OmarTRBN/STM32_Robotic_Arm/README.md

# STM32_Robotic_Arm
Capstone project - STM32-controlled 4DOF robotic arm designed for trajectory tracking, controller comparison and system identification experiments.
