OmarTRBN/STM32_Robotic_Arm/Images/FrontView.png

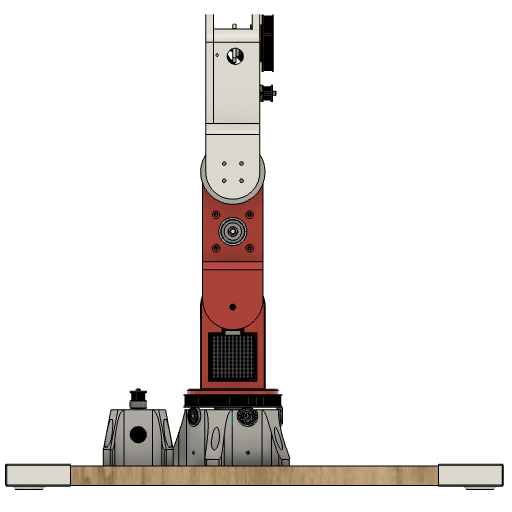
Images/FrontView.png
