OmarTRBN/STM32_Robotic_Arm/Images/HomeView.png

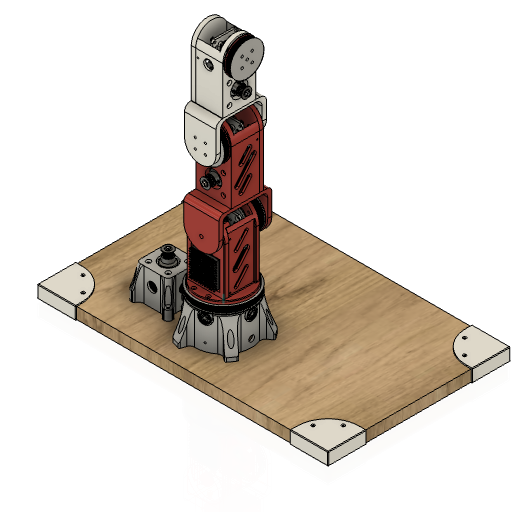
Images/HomeView.png
