OmarTRBN/STM32_Robotic_Arm/Images/link1_analysis.png

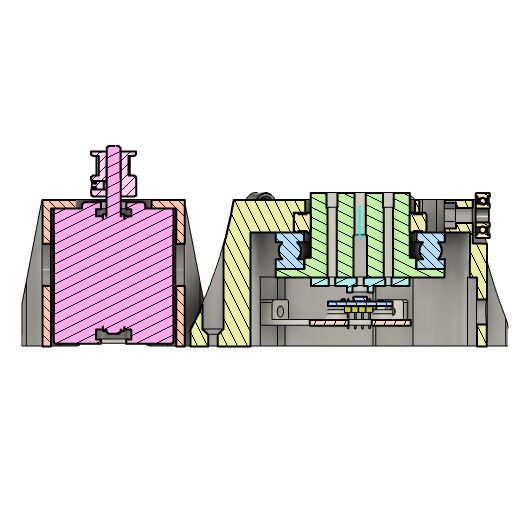
Images/link1_analysis.png
