OmarTRBN/STM32_Robotic_Arm/Images/link2_analysis.png

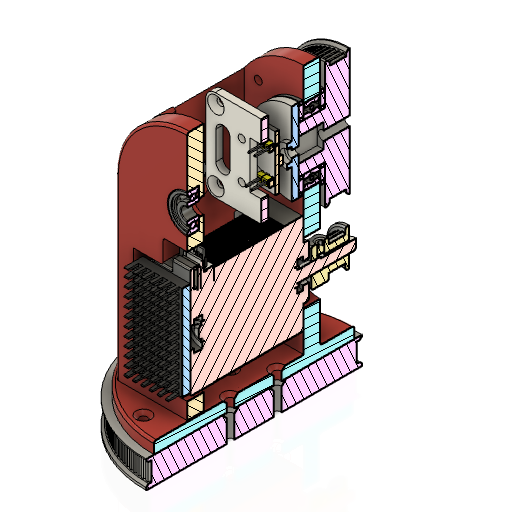
Images/link2_analysis.png
