OmarTRBN/STM32_Robotic_Arm/Images/link3_analysis.png

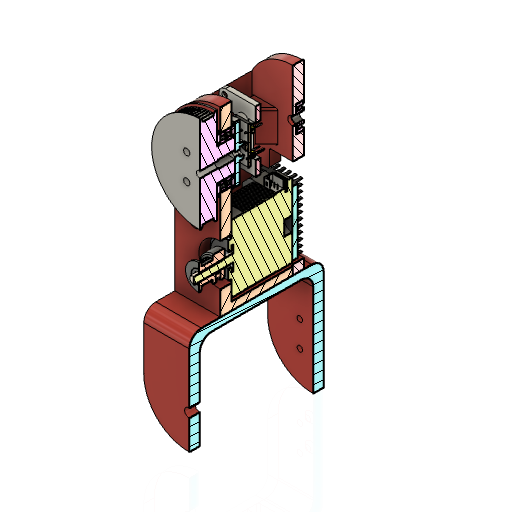
Images/link3_analysis.png
