OmarTRBN/STM32_Robotic_Arm/Images/link4_analysis.png

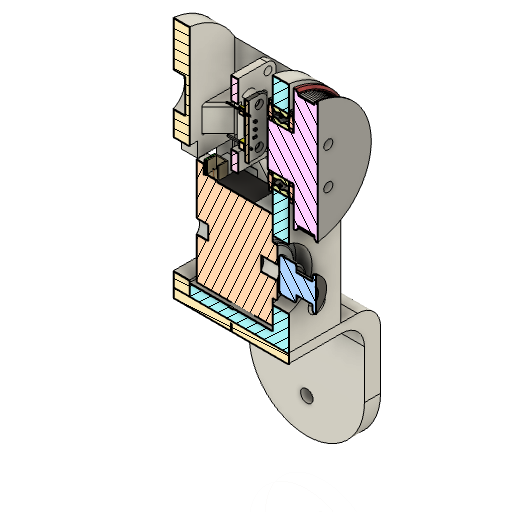
Images/link4_analysis.png
