OmarTRBN/STM32_Robotic_Arm/Images/RightView.png

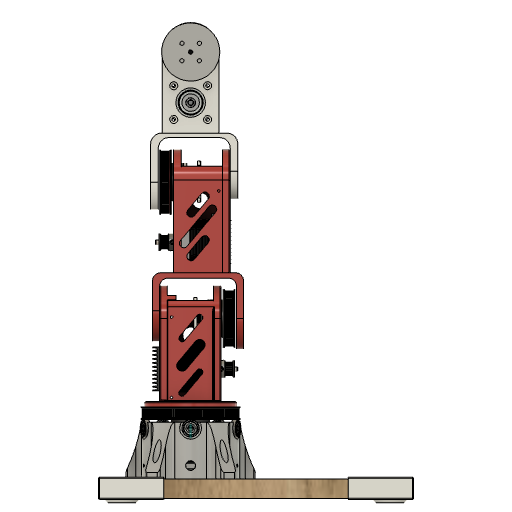
Images/RightView.png
