OmarTRBN/STM32_Robotic_Arm/CAD/STEP/l1/l1_sensor_holder.step

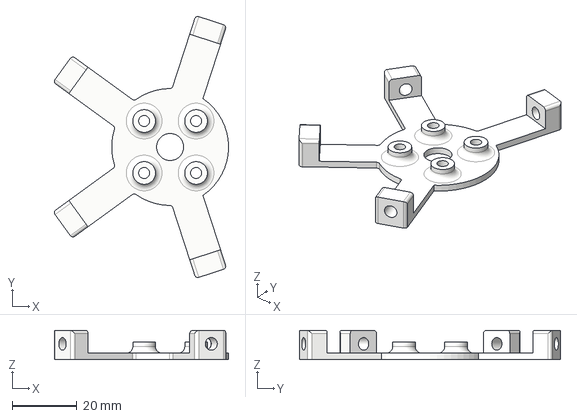
[picture p8: CAD file, 2025-03-30]
CAD/STEP/l1/l1_sensor_holder.step
53.6 x 80.4 x 9.00 mm
