OmarTRBN/STM32_Robotic_Arm/CAD/STEP/l2/l2_encoder_plate.step

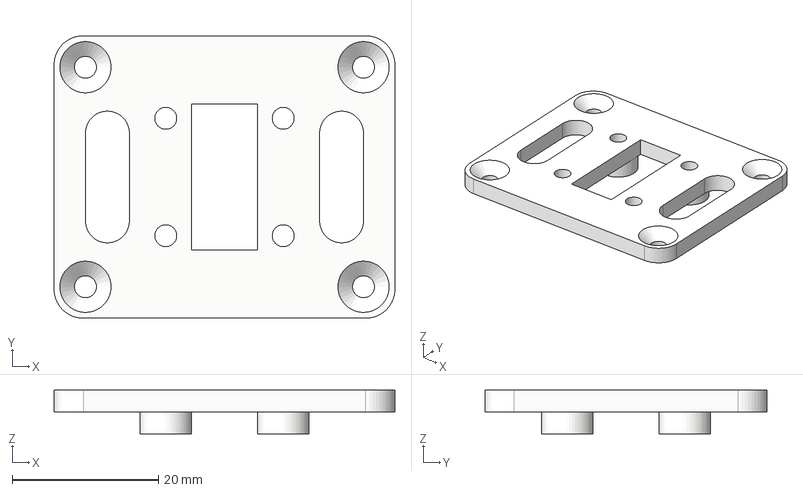
[picture p9: CAD file, 2025-03-08]
CAD/STEP/l2/l2_encoder_plate.step
46.6 x 38.6 x 6.00 mm
