OmarTRBN/STM32_Robotic_Arm/CAD/STEP/l3/l3_sensor_part.step

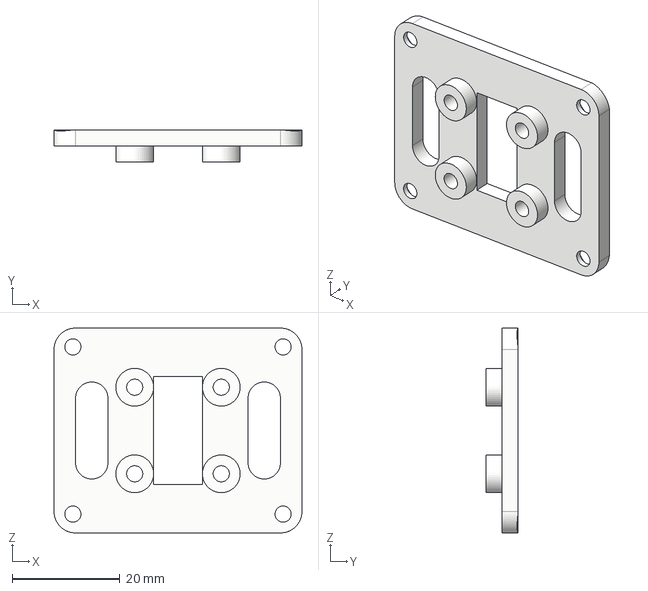
[picture p10: CAD file, 2025-06-22]
CAD/STEP/l3/l3_sensor_part.step
46.0 x 6.00 x 38.0 mm
