OmarTRBN/STM32_Robotic_Arm/KiCad_perfboard_sketch/ra_perfboard/3D_Models/TCA9548A_3d.step

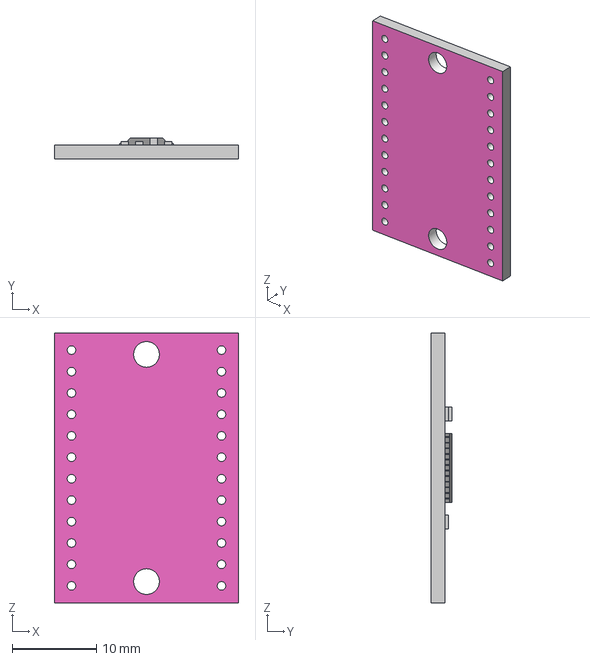
[picture p12: CAD file, 2025-03-06]
KiCad_perfboard_sketch/ra_perfboard/3D_Models/TCA9548A_3d.step
21.8 x 2.44 x 32.0 mm
