OmarTRBN/STM32_Robotic_Arm/KiCad_perfboard_sketch/ra_perfboard/3D_Models/TMC2208_3d.step

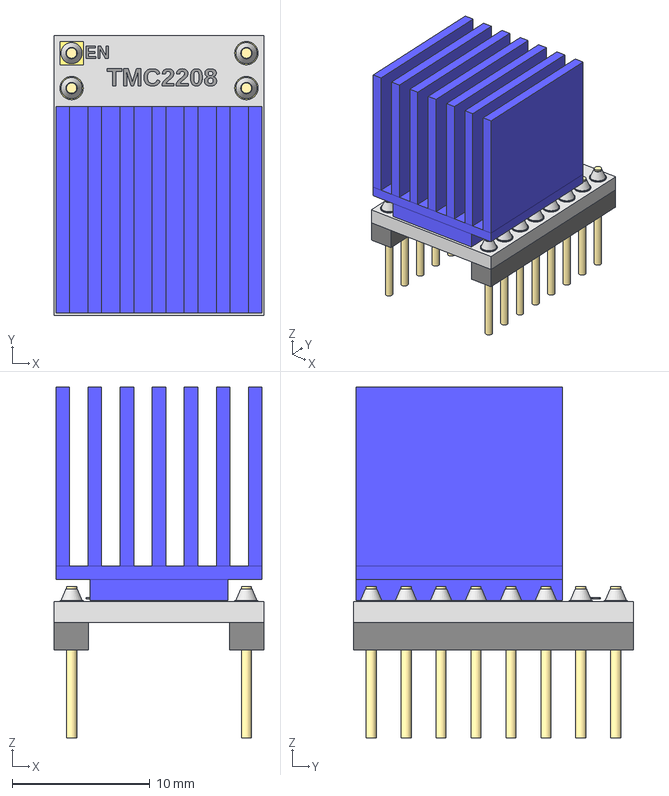
[picture p13: CAD file, 2025-03-06]
KiCad_perfboard_sketch/ra_perfboard/3D_Models/TMC2208_3d.step
15.2 x 20.3 x 25.5 mm
tmcpcb
Heat
Pin003
Solder001
ENpad
ENSolder
ENLongPin
Pin005
Solder002
Pin007
Solder003
Pin009
Solder004
Pin011
Solder005
Pin013
Solder006
Pin015
Solder007
Pin017
Solder008
Pin019
Solder009
Pin021
Solder010
Pin023
Solder011
Pin025
Solder012
Pin027
Solder013
Pin029
Solder014
Pin031
Solder015
PlasticHeader002
PlasticHeader003
