OmarTRBN/STM32_Robotic_Arm/(list of files, cad)

Other CAD files:
CAD/STEP/gripper/gripper_assembly v6.3mf
