OmarTRBN/STM32_Robotic_Arm/KiCad_perfboard_sketch/ra_perfboard/ra_perfboard.kicad_pcb

## KiCad design KiCad_perfboard_sketch/ra_perfboard/ra_perfboard.kicad_pcb (2025-07-10)

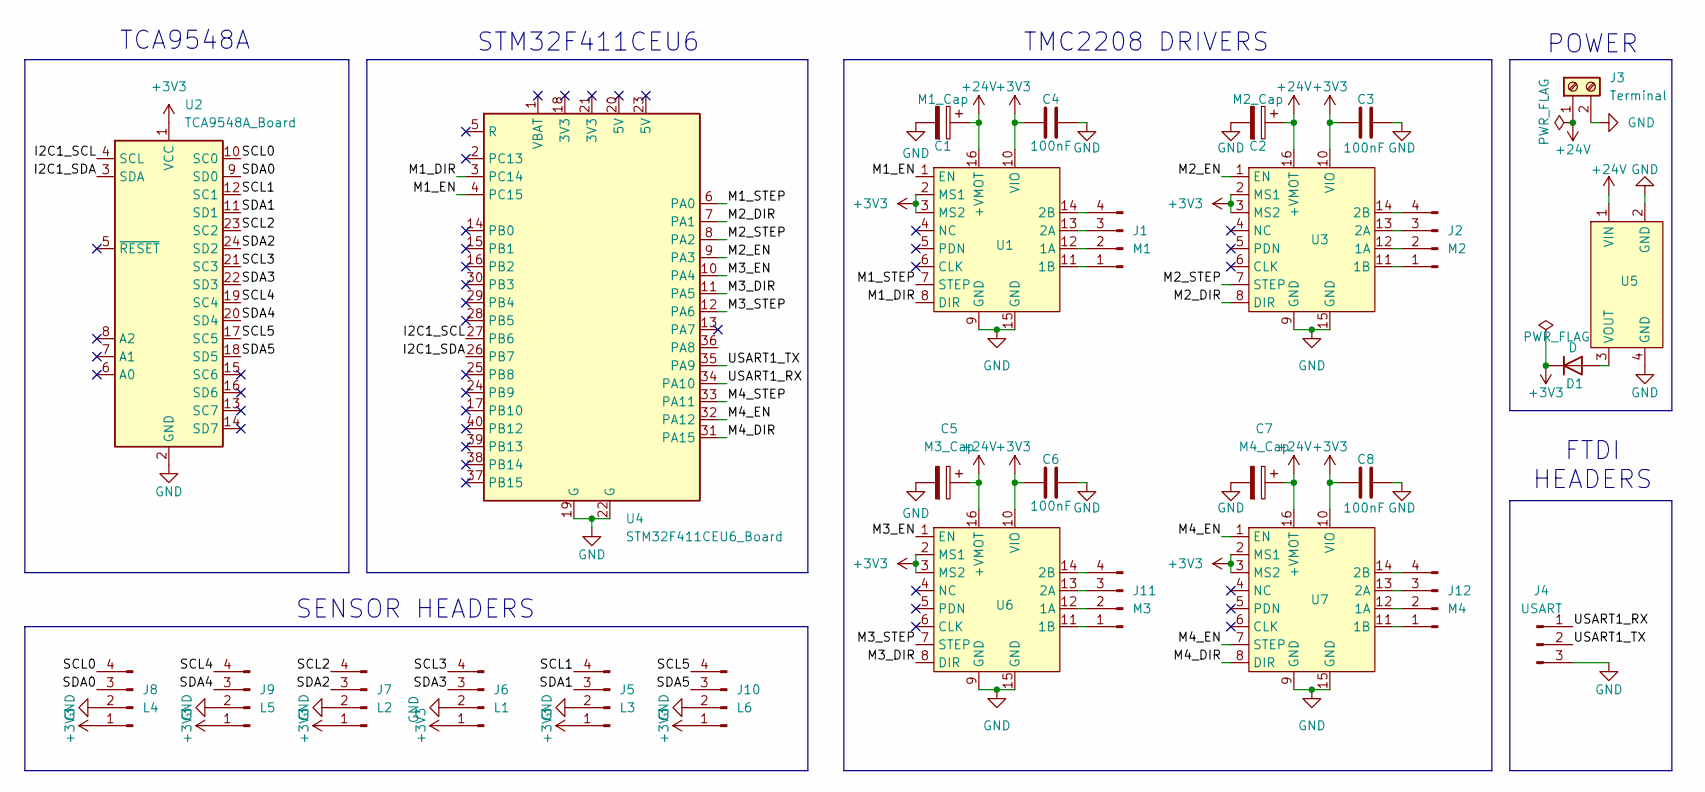
[picture p14: schematic ra_perfboard.kicad_sch, Robot Arm Circuit]

Parts:
C1: M1_Cap; CP_Radial_D5.0mm_P2.50mm
C2: M2_Cap; CP_Radial_D5.0mm_P2.50mm
C3, C4, C6, C8: 100nF; C_Disc_D3.0mm_W2.0mm_P2.50mm
C5: M3_Cap; CP_Radial_D5.0mm_P2.50mm
C7: M4_Cap; CP_Radial_D5.0mm_P2.50mm
D1: D; D_DO-15_P10.16mm_Horizontal
J1: M1; PinHeader_1x04_P2.54mm_Vertical
J2: M2; PinHeader_1x04_P2.54mm_Vertical
J3: Terminal; TerminalBlock_Phoenix_MKDS-1,5-2-5.08_1x02_P5.08mm_Horizont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
J4: USART; PinHeader_1x03_P2.54mm_Vertical
J5: L3; PinHeader_1x04_P2.54mm_Vertical
J6: L1; PinHeader_1x04_P2.54mm_Vertical
J7: L2; PinHeader_1x04_P2.54mm_Vertical
J8: L4; PinHeader_1x04_P2.54mm_Vertical
J9: L5; PinHeader_1x04_P2.54mm_Vertical
J10: L6; PinHeader_1x04_P2.54mm_Vertical
J11: M3; PinHeader_1x04_P2.54mm_Vertical
J12: M4; PinHeader_1x04_P2.54mm_Vertical
U1, U3, U6, U7: TMC2208_Board_Footprint
U2: TCA9548A_Board; TCA9548A_Board_Footprint
U4: STM32F411CEU6_Board
U5: LM2596_Board_BC_Footprint

Connections:
+3V3: C3.1, C4.1, C6.1, C8.1, D1.1 (K), J5.1, J6.1, J7.1, J8.1, J9.1, J10.1, U1.2 (MS1), U1.3 (MS2), U1.10 (VIO), U2.1 (VCC), U3.2 (MS1), U3.3 (MS2), U3.10 (VIO), U6.2 (MS1), U6.3 (MS2), U6.10 (VIO), U7.2 (MS1), U7.3 (MS2), U7.10 (VIO)
+24V: C1.1, C2.1, C5.1, C7.1, J3.1, U1.16 (+VMOT), U3.16 (+VMOT), U5.1 (VIN), U6.16 (+VMOT), U7.16 (+VMOT)
/I2C1_SCL: U2.4 (SCL), U4.27 (PB6)
/I2C1_SDA: U2.3 (SDA), U4.26 (PB7)
/M1_DIR: U1.8 (DIR), U4.3 (PC14)
/M1_EN: U1.1 (EN), U4.4 (PC15)
/M1_STEP: U1.7 (STEP), U4.6 (PA0)
/M2_DIR: U3.8 (DIR), U4.7 (PA1)
/M2_EN: U3.1 (EN), U4.9 (PA3)
/M2_STEP: U3.7 (STEP), U4.8 (PA2)
/M3_DIR: U4.11 (PA5), U6.8 (DIR)
/M3_EN: U4.10 (PA4), U6.1 (EN)
/M3_STEP: U4.12 (PA6), U6.7 (STEP)
/M4_DIR: U4.31 (PA15), U7.8 (DIR)
/M4_EN: U4.32 (PA12), U7.1 (EN), U7.7 (STEP)
/M4_STEP: U4.33 (PA11)
/SCL0: J8.4, U2.10 (SC0)
/SCL1: J5.4, U2.12 (SC1)
/SCL2: J7.4, U2.23 (SC2)
/SCL3: J6.4, U2.21 (SC3)
/SCL4: J9.4, U2.19 (SC4)
/SCL5: J10.4, U2.17 (SC5)
/SDA0: J8.3, U2.9 (SD0)
/SDA1: J5.3, U2.11 (SD1)
/SDA2: J7.3, U2.24 (SD2)
/SDA3: J6.3, U2.22 (SD3)
/SDA4: J9.3, U2.20 (SD4)
/SDA5: J10.3, U2.18 (SD5)
/USART1_RX: J4.1, U4.34 (PA10)
/USART1_TX: J4.2, U4.35 (PA9)
GND: C1.2, C2.2, C3.2, C4.2, C5.2, C6.2, C7.2, C8.2, J3.2, J4.3, J5.2, J6.2, J7.2, J8.2, J9.2, J10.2, U1.9 (GND), U1.15 (GND), U2.2 (GND), U3.9 (GND), U3.15 (GND), U4.19 (G), U4.22 (G), U5.2 (GND), U5.4 (GND), U6.9 (GND), U6.15 (GND), U7.9 (GND), U7.15 (GND)
unnamed: D1.2 (A), U5.3 (VOUT)
unnamed: J1.1, U1.11 (1B)
unnamed: J1.2, U1.12 (1A)
unnamed: J1.3, U1.13 (2A)
unnamed: J1.4, U1.14 (2B)
unnamed: J2.1, U3.11 (1B)
unnamed: J2.2, U3.12 (1A)
unnamed: J2.3, U3.13 (2A)
unnamed: J2.4, U3.14 (2B)
unnamed: J11.1, U6.11 (1B)
unnamed: J11.2, U6.12 (1A)
unnamed: J11.3, U6.13 (2A)
unnamed: J11.4, U6.14 (2B)
unnamed: J12.1, U7.11 (1B)
unnamed: J12.2, U7.12 (1A)
unnamed: J12.3, U7.13 (2A)
unnamed: J12.4, U7.14 (2B)

Notes on the sheet:
TCA9548A
POWER
TMC2208 DRIVERS
SENSOR HEADERS
STM32F411CEU6
FTDI HEADERS

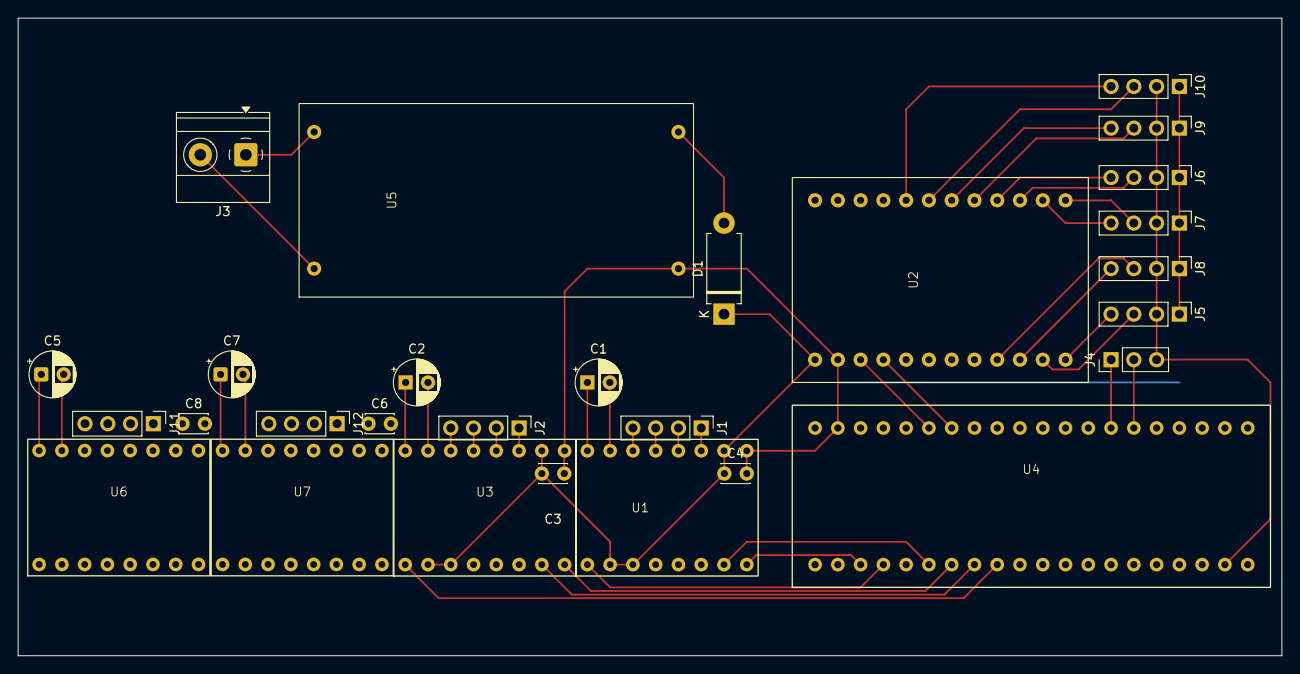
[picture p15: board ra_perfboard.kicad_pcb from above]

Board: 2 copper layers, 141.0 x 71.1 mm, 28 parts (0 on the bottom side), 47 nets.
