OmarTRBN/STM32_Robotic_Arm/STM32_main_code/ra_main.ioc

Mcu.UserName=STM32F411CEUx
PA0-WKUP.Signal=S_TIM5_CH1
PA1.GPIO_Label=M2_DIR
PA1.Signal=GPIO_Output
PA10.Signal=USART1_RX
PA11.Signal=S_TIM1_CH4
PA12.GPIO_Label=M4_EN
PA12.Signal=GPIO_Output
PA13.Signal=SYS_JTMS-SWDIO
PA14.Signal=SYS_JTCK-SWCLK
PA15.GPIO_Label=M4_DIR
PA15.Signal=GPIO_Output
PA2.Signal=S_TIM9_CH1
PA3.GPIO_Label=M2_EN
PA3.Signal=GPIO_Output
PA4.GPIO_Label=M3_EN
PA4.Signal=GPIO_Output
PA5.GPIO_Label=M3_DIR
PA5.Signal=GPIO_Output
PA6.Signal=S_TIM3_CH1
PA9.Signal=USART1_TX
PB6.Signal=I2C1_SCL
PB7.Signal=I2C1_SDA
PC13-ANTI_TAMP.GPIO_Label=TEST_LED
PC13-ANTI_TAMP.Signal=GPIO_Output
PC14-OSC32_IN.GPIO_Label=M1_DIR
PC14-OSC32_IN.Signal=GPIO_Output
PC15-OSC32_OUT.GPIO_Label=M1_EN
PC15-OSC32_OUT.Signal=GPIO_Output
