OmarTRBN/STM32_Robotic_Arm/STM32_main_code/Core/Inc/main.h

#define AS5600_MAX 4096.0        // 12-bit AS5600 range (0-4095)
#define RAD_TO_AS5600 (AS5600_MAX / 2.0 * M_PI)
#define DEG_TO_AS5600 (AS5600_MAX / 360.0)
#define AS5600_TO_RAD (2.0 * M_PI / AS5600_MAX)
#define NUM_JOINTS_TRAJ 2
#define TRAJ_POLY_TERMS 6
#define TRAJ_COEFF_LEN NUM_JOINTS_TRAJ*TRAJ_POLY_TERMS
#define TEST_LED_Pin GPIO_PIN_13
#define TEST_LED_GPIO_Port GPIOC
#define M1_DIR_Pin GPIO_PIN_14
#define M1_DIR_GPIO_Port GPIOC
#define M1_EN_Pin GPIO_PIN_15
#define M1_EN_GPIO_Port GPIOC
#define M2_DIR_Pin GPIO_PIN_1
#define M2_DIR_GPIO_Port GPIOA
#define M2_EN_Pin GPIO_PIN_3
#define M2_EN_GPIO_Port GPIOA
#define M3_EN_Pin GPIO_PIN_4
#define M3_EN_GPIO_Port GPIOA
#define M3_DIR_Pin GPIO_PIN_5
#define M3_DIR_GPIO_Port GPIOA
#define M4_EN_Pin GPIO_PIN_12
#define M4_EN_GPIO_Port GPIOA
#define M4_DIR_Pin GPIO_PIN_15
#define M4_DIR_GPIO_Port GPIOA
