OmarTRBN/STM32_Robotic_Arm/STM32_main_code/Core/Application/App/app.c

/*
 * app.c
 *
 *  Created on: May 11, 2025
 *      Author: omart
 */

#include "app.h"

/* 🥊🥊🥊 Serial Communication 🥊🥊🥊 */
SerialComm_HandleTypeDef appSerialHandle;
SerialComm_StatusTypeDef appSerialStatus;
uint8_t appSerialRxArray[SERIALCOMM_RX_BUFF_SIZE] = {0};
uint8_t appSerialTxArray[SERIALCOMM_TX_BUFF_SIZE] = {0};

/* 🥊🥊🥊 Encoders 🥊🥊🥊 */
AS5600_MUX_HandleTypeDef appMuxHandle;
AS5600_MUX_StatusTypeDef appMuxStatus;

/*🥊🥊🥊 Motors 🥊🥊🥊*/
STEPMOTOR_HandleTypeDef appStepMotors[NUM_JOINTS];
STEPMOTOR_StatusTypeDef appStepMotorStatus;

void App_InitMotors(void) {
    for (int i = 0; i < NUM_JOINTS; i++) {
        appStepMotorStatus = STEPMOTOR_Init(&appStepMotors[i], i);
    }
}

/*🥊🥊🥊 PID Control 🥊🥊🥊*/
float q_set[NUM_JOINTS];
float q_meas[NUM_JOINTS];
float q_out[NUM_JOINTS];
MultivariablePID appPidObj;

/*🥊🥊🥊 Trajectory 🥊🥊🥊*/
Trajectory robotTraj;
