OmarTRBN/STM32_Robotic_Arm/STM32_main_code/Core/HW_Drivers/StepMotor/lut.c

/*
 * LUT.c
 *
 *  Created on: Mar 2, 2025
 *      Author: omart
 */

#include "lut.h"

const uint16_t LUT_PSC[LUT_SIZE] = { 381, 190, 127, 95, 76, 63, 54, 47, 42, 38, 34, 31, 29, 27, 25, 23, 22, 21, 20, 19, 18, 17, 16, 15, 15, 14, 14, 13, 13, 12, 12, 11, 11, 11, 10, 10, 10, 10, 9, 9, 9, 9, 8, 8, 8, 8, 8, 7, 7, 7, 7, 7, 7, 7, 6, 6, 6, 6, 6, 6, 6, 6, 6, 5, 5, 5, 5, 5, 5, 5, 5, 5, 5, 5, 5, 5, 4, 4, 4, 4, 4, 4, 4, 4, 4, 4, 4, 4, 4, 4, 4, 4, 4, 4, 4, 3, 3, 3, 3, 3, 3, 3, 3, 3, 3, 3, 3, 3, 3, 3, 3, 3, 3, 3, 3, 3, 3, 3, 3, 3, 3, 3, 3, 3, 3, 3, 3, 2, 2, 2, 2, 2, 2, 2, 2, 2, 2, 2, 2, 2, 2, 2, 2, 2, 2, 2, 2, 2, 2, 2, 2, 2, 2, 2, 2, 2, 2, 2, 2, 2, 2, 2, 2, 2, 2, 2, 2, 2, 2, 2, 2, 2, 2, 2, 2, 2, 2, 2, 2, 2, 2, 2, 2, 2, 2, 2, 2, 2, 2, 2, 1, 1, 1, 1, 1, 1, 1, 1, 1, 1, 1, 1, 1, 1, 1, 1, 1, 1, 1, 1, 1, 1, 1, 1, 1, 1, 1, 1, 1, 1, 1, 1, 1, 1, 1, 1, 1, 1, 1, 1, 1, 1, 1, 1, 1, 1, 1, 1, 1, 1, 1, 1, 1, 1, 1, 1, 1, 1, 1, 1, 1, 1, 1, 1, 1, 1, 1, 1, 1, 1, 1, 1, 1, 1, 1, 1, 1, 1, 1, 1, 1, 1, 1, 1, 1, 1, 1, 1, 1, 1, 1, 1, 1, 1, 1, 1, 1, 1, 1, 1, 1, 1, 1, 1, 1, 1, 1, 1, 1, 1, 1, 1, 1, 1, 1, 1, 1, 1, 1, 1, 1, 1, 1, 1, 1, 1, 1, 1, 1, 1, 1, 1, 1, 1, 1, 1, 1, 1, 1, 1, 1, 1, 1, 1, 1, 1, 1, 1, 1, 1, 1, 1, 1, 1, 1, 1, 1, 1, 1, 1, 1, 1, 1, 1, 1, 1, 1, 1, 1, 1, 1, 1, 1, 1, 1, 1, 1, 1, 1, 1, 1, 1, 1, 1, 1, 1, 1, 1, 1, 1, 1, 0, 0, 0, 0, 0, 0, 0, 0, 0, 0, 0, 0, 0, 0, 0, 0, 0, 0, 0, 0, 0, 0, 0, 0, 0, 0, 0, 0, 0, 0, 0, 0, 0, 0, 0, 0, 0, 0, 0, 0, 0, 0, 0, 0, 0, 0, 0, 0, 0, 0, 0, 0, 0, 0, 0, 0, 0, 0, 0, 0, 0, 0, 0, 0, 0, 0, 0, 0, 0, 0, 0, 0, 0, 0, 0, 0, 0, 0, 0, 0, 0, 0, 0, 0, 0, 0, 0, 0, 0, 0, 0, 0, 0, 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
0, 0, 0, 0, 0, 0, 0, 0, 0, 0, 0, 0, 0, 0, 0, 0, 0, 0, 0, 0, 0, 0, 0, 0, 0, 0 };
const uint16_t LUT_ARR[LUT_SIZE] = { 65444, 65444, 65103, 65103, 64934, 65103, 64934, 65103, 64598, 64102, 64934, 65103, 64102, 63775, 64102, 65103, 63938, 63130, 62656, 62499, 62656, 63130, 63938, 65103, 62499, 64102, 61727, 63775, 61575, 64102, 62034, 65103, 63130, 61274, 64934, 63130, 61424, 59808, 64102, 62499, 60975, 59523, 64598, 63130, 61727, 60385, 59101, 65103, 63775, 62499, 61274, 60095, 58961, 57869, 64934, 63775, 62656, 61575, 60532, 59523, 58547, 57603, 56688, 65103, 64102, 63130, 62188, 61274, 60385, 59523, 58684, 57869, 57077, 56305, 55555, 54824, 64934, 64102, 63290, 62499, 61727, 60975, 60240, 59523, 58823, 58139, 57470, 56817, 56179, 55555, 54944, 54347, 53762, 53190, 52631, 65103, 64432, 63775, 63130, 62499, 61880, 61274, 60679, 60095, 59523, 58961, 58410, 57869, 57338, 56817, 56305, 55803, 55309, 54824, 54347, 53878, 53418, 52965, 52520, 52082, 51652, 51229, 50812, 50402, 49999, 49602, 49212, 65103, 64598, 64102, 63612, 63130, 62656, 62188, 61727, 61274, 60826, 60385, 59951, 59523, 59101, 58684, 58274, 57869, 57470, 57077, 56688, 56305, 55927, 55555, 55187, 54824, 54465, 54112, 53762, 53418, 53078, 52742, 52410, 52082, 51759, 51439, 51124, 50812, 50504, 50200, 49899, 49602, 49309, 49019, 48732, 48449, 48169, 47892, 47618, 47347, 47080, 46815, 46554, 46295, 46040, 45787, 45536, 45289, 45044, 44802, 44562, 44325, 44091, 43859, 65444, 65103, 64766, 64432, 64102, 63775, 63451, 63130, 62813, 62499, 62188, 61880, 61575, 61274, 60975, 60679, 60385, 60095, 59808, 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
