OmarTRBN/STM32_Robotic_Arm/STM32_main_code/Core/Application/App/main_init.h

/*
 * main_init.h
 *
 *  Created on: Jun 19, 2025
 *      Author: omarmac
 */

#ifndef APP_MAIN_INIT_H_
#define APP_MAIN_INIT_H_

#include "app_includes.h"

void App_Init(void);

#endif /* APP_MAIN_INIT_H_ */
