OmarTRBN/STM32_Robotic_Arm/STM32_main_code/Core/Application/App/app_includes.h

/*
 * app_includes.h
 *
 *  Created on: Jun 19, 2025
 *      Author: omarmac
 */

#ifndef APP_APP_INCLUDES_H_
#define APP_APP_INCLUDES_H_

// Core application API
#include "app.h"
#include "app_config.h"
#include "main_init.h"
#include "parserFcns.h"

#include "StepMotor.h"
#include "SerialComm.h"
#include "AS5600_Mux.h"
#include "PID_Control.h"

// Common utilities
#include <stdio.h>
#include <stdlib.h>
#include <stdint.h>
#include <string.h>
#include <stdbool.h>
#include <math.h>

#endif /* APP_APP_INCLUDES_H_ */
