OmarTRBN/STM32_Robotic_Arm/STM32_main_code/Core/HW_Drivers/AS5600_Mux/AS5600_Mux_Def.h

/*
 * AS5600_Mux_Def.h
 *
 *  Created on: May 11, 2025
 *      Author: omart
 */

#ifndef HW_DRIVERS_AS5600_MUX_AS5600_MUX_DEF_H_
#define HW_DRIVERS_AS5600_MUX_AS5600_MUX_DEF_H_

#include "main.h"

#define TCA9548A_ADDR  (0x70 << 1)
#define AS5600_ADDR    (0x36 << 1)
#define ANGLE_MSB_REG  0x0E
#define ANGLE_LSB_REG  0x0F

#define AS5600_MUX_I2C &hi2c1

#define AS5600_MUX_MAX_CHANNELS 8
#define AS5600_MUX_TIMEOUT 10
#define AS5600_MUX_DEFAULT_HANDLE 2048

#define AS5600_MUX_INITIALIZED 1
#define AS5600_MUX_NOT_INITIALIZED 0

typedef enum {
	AS5600_MUX_OK,
	AS5600_MUX_ERROR,
	AS5600_MUX_NONE
} AS5600_MUX_StatusTypeDef;

typedef struct {
    bool is_initialized;

	uint8_t num_channels;
    AS5600_MUX_StatusTypeDef channel_states[AS5600_MUX_MAX_CHANNELS];
    uint16_t channel_raw_values[AS5600_MUX_MAX_CHANNELS];
} AS5600_MUX_HandleTypeDef;

#endif /* HW_DRIVERS_AS5600_MUX_AS5600_MUX_DEF_H_ */
