OmarTRBN/STM32_Robotic_Arm/STM32_main_code/Core/HW_Drivers/StepMotor/lut.h

/*
 * LUT.h
 *
 *  Created on: Mar 2, 2025
 *      Author: omart
 */

#ifndef INC_LUT_H_
#define INC_LUT_H_

#include "main.h"

#define LUT_SIZE 5000

extern const uint16_t LUT_PSC[LUT_SIZE];	// Prescaler array
extern const uint16_t LUT_ARR[LUT_SIZE];	// Auto-Reload array

#endif /* INC_LUT_H_ */
