OmarTRBN/STM32_Robotic_Arm/(commit log)

2025-03-04 Initial commit of STM32 Robotic Arm project.
    [LUT.csv, ra_main Debug.cfg]
2025-03-04 Added Multivariable PID library.
2025-03-04 Performed first test of Multivariable PID library.
2025-03-06 Added TMC2208 board symbol and footprint.
    [TMC2208_3d.step, ra_perfboard.kicad_pcb, ra_perfboard.kicad_sch]
2025-03-06 Added STM32 board symbol and footprint.
    [ra_perfboard.kicad_pcb, ra_perfboard.kicad_sch]
2025-03-06 Added TCA9548A and LM3596 boards to perfboard layout.
    [LM2596_3d.step, TCA9548A_3d.step, ra_perfboard.kicad_pcb, ra_perfboard.kicad_sch]
2025-03-08 Configured pins in .ioc file and worked on KiCad perfboard.
    [l2_encoder_plate.step, ra_perfboard.kicad_pcb, ra_perfboard.kicad_sch]
2025-03-10 Updated commands to be use 2 bytes instead of 1, and made modifications on perfboard and pins.
    [LUT.csv, ra_perfboard.kicad_pcb, ra_perfboard.kicad_sch]
2025-03-17 Removed bug in LUT set speed function. Updates to MATLAB GUI and KiCad perfboard. Successfully tested TCA9548A library.
    [ra_perfboard.kicad_pcb, ra_perfboard.kicad_sch]
2025-03-20 Added buttons in GUI to enable/disable motors along with STM32 functions to handle them.
2025-03-20 Added PID parameter parsing functions.
2025-03-27 Added plotting and animating trajectory functions in MATLAB.
    [gripper_assembly v6.3mf, gripper_assembly v6.step]
2025-03-30 Added trajectory button layout to MATLAB GUI.
    [l1_sensor_holder.step]
2025-05-11 Modified AS5600_Mux library and added DMA functionality.
    [ra_perfboard.kicad_sch]
2025-05-22 Added modular SerialComm library to replace CommandProtocol.
    [AS5600_Mux_Def.h, PID_Control.c, SerialComm.c, SerialComm.h, StepMotor.c, StepMotor.h, StepMotor_Def.h]
2025-05-22 Fixed bug in controller parameters parsing function.
    [AS5600_Mux.c, AS5600_Mux.h, AS5600_Mux_Def.h, PID_Control.c, SerialComm.h, app.c, app.h]
2025-06-18 Added Mutex for UART communication for simultaneous data reception and transmission.
    [ra_main Debug.cfg]
2025-06-20 Added sliders for manual joint setpoint control to the MATLAB GUI.
    [LUT.csv]
2025-06-22 Organized STM32 project files, tested all 4 AS5600 modules successfully.
    [l3_sensor_part.step, ra_perfboard.kicad_sch]
2025-07-10 Final commit after submitting project. Currently no plans to proegress in this project any further.
    [ra_perfboard.kicad_pcb, ra_perfboard.kicad_sch]
